sbgisen/bldc-hardware/(threads)

Thread 1 (2017-10-17):

D4 plus-minus problem

nyxrobotics, 2017-10-17:
##Abstract
The diode "D4" is interghanged between schematic and pattern.

Thread 2 (2017-10-17):

D12~D23 problem

nyxrobotics, 2017-10-17:
##Abstract
The diode "D12~23" wont suit pattern.

Thread 3 (2017-10-17):

C53~55 problem

nyxrobotics, 2017-10-17:
##Abstract
The capacitor "C53~55" wont suit pattern.
