sbgisen/bldc-hardware/(commit log)

2017-07-31 Add snubber circuit
    [BLDC4.12_BOM.ods, BLDC_4.kicad_pcb, BLDC_4.sch, CAN.sch, Power.sch, STM32F4 64LQFP.sch, mosfets.sch]
2017-08-02 Add footprint of USB Micro B
    [BLDC_4.kicad_pcb, BLDC_4.sch, BLDC_4_old.kicad_pcb]
2017-08-02 Add a LED footprint and layout board
    [BLDC_4.kicad_pcb, BLDC_4.sch]
2017-08-04 layout modified
    [BLDC_4.kicad_pcb]
2017-08-08 almost finished to layout
    [BLDC_4.kicad_pcb]
2017-08-08 Add resisteres to prevent ringing in falling
    [BLDC_4.kicad_pcb, mosfets.sch]
2017-08-08 draw wires of MOSFETs
    [BLDC_4.kicad_pcb, BLDC_4.sch]
2017-08-08 wire around FET driver
    [BLDC_4.kicad_pcb]
2017-08-09 layout around FET driver
    [BLDC_4.kicad_pcb]
2017-08-10 layout around a MCU
    [BLDC_4.kicad_pcb, BLDC_4.sch, Power.sch, STM32F4 64LQFP.sch]
2017-08-10 finish wire
    [BLDC_4.kicad_pcb, BLDC_4.sch, CAN.sch, Power.sch, STM32F4 64LQFP.sch, hall_filters.sch, temp.sch]
2017-08-17 All wires are connected
    [BLDC_4.kicad_pcb]
2017-08-17 Add test pins
    [BLDC_4.kicad_pcb, BLDC_4.sch, CAN.sch, Power.sch, STM32F4 64LQFP.sch, hall_filters.sch, mosfets.sch, temp.sch]
2017-08-17 modify silks
    [BLDC_4.kicad_pcb]
2017-08-17 Add logos
    [BLDC_4.kicad_pcb]
2017-08-18 generate gerber files
    [BLDC_4-B.Cu.gbr, BLDC_4-B.Mask.gbr, BLDC_4-B.SilkS.gbr, BLDC_4-B_Cu.gbl, BLDC_4-B_Mask.gbs, BLDC_4-B_Paste.gbp, BLDC_4-B_SilkS.gbo, BLDC_4-Edge.Cuts.gbr]
2017-08-18 renew BOM
    [BLDC4.12_BOM.ods, Power.sch]
2017-08-18 reroute wires
    [BLDC_4.kicad_pcb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]
2017-08-21 layout edited and plot
    [BLDC_4.kicad_pcb, BLDC_4_BOM.csv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]
2017-08-22 edit silk layout
    [BLDC_4-B.Cu.gbl, BLDC_4-B.Cu.gbr, BLDC_4-B.Mask.gbs, BLDC_4-B.SilkS.gbo, BLDC_4-F.Cu.gbr, BLDC_4-F.Cu.gtl, BLDC_4-F.Mask.gts, BLDC_4-F.SilkS.gto]
2017-08-22 Change parts
    [BLDC4.12_BOM.ods, BLDC_4_BOM.ods, BLDC_4_BOM.xls]
2017-08-25 Change unavailable parts
    [BLDC_4_BOM.xls]
2017-08-29 Output gerbers
    [BLDC_4.kicad_pcb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]
